SamiraWettasinghe/DAQ/README.md

# DAQ
Open source data acquisition system designed for the grassroots motorsports enthusiast.
