SamiraWettasinghe/DAQ/Schematic/Mega_Shield/Mega_Shieldv4.step

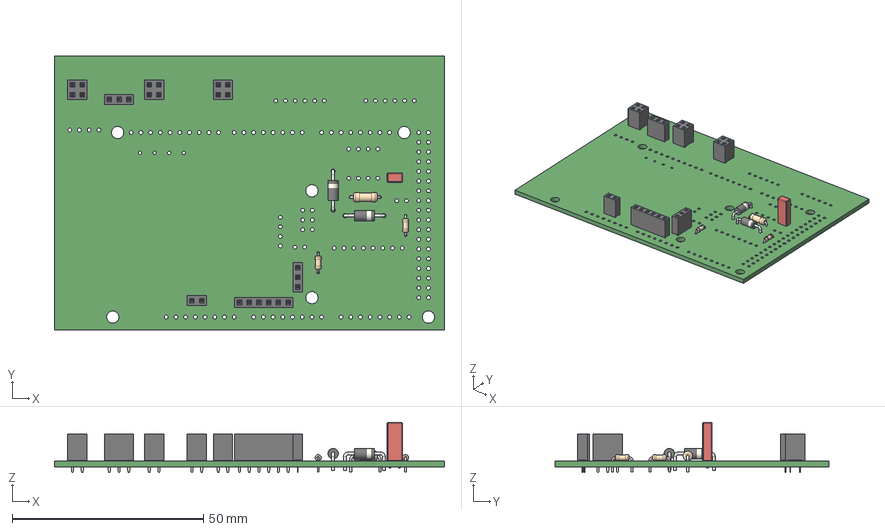
[picture p2: CAD file, 2021-03-08]
Schematic/Mega_Shield/Mega_Shieldv4.step
102.0 x 71.8 x 13.1 mm
