SamiraWettasinghe/DAQ/Schematic/TTS/DXF/TTS-B_Cu.dxf

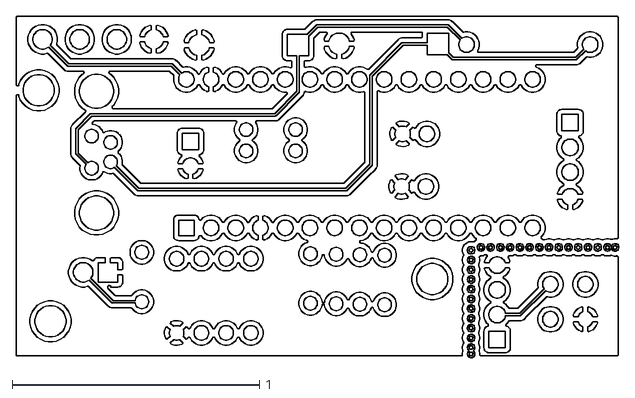
[picture p3: CAD file, 2021-02-11]
Schematic/TTS/DXF/TTS-B_Cu.dxf
2.44 x 1.38
