SamiraWettasinghe/DAQ/Schematic/TTS/TTSv4.step

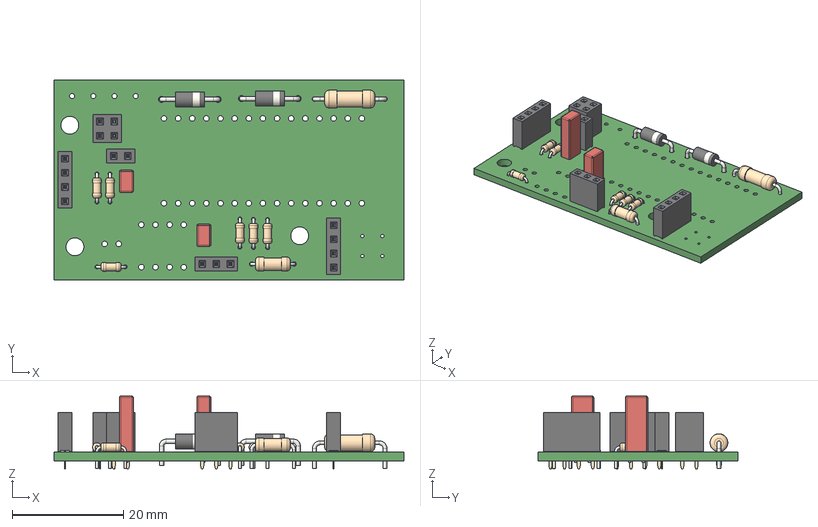
[picture p4: CAD file, 2021-03-08]
Schematic/TTS/TTSv4.step
62.9 x 35.9 x 13.1 mm
