SamiraWettasinghe/DAQ/Schematic/Mega_Shield/DXF/Mega_Shield-B_Cu.dxf

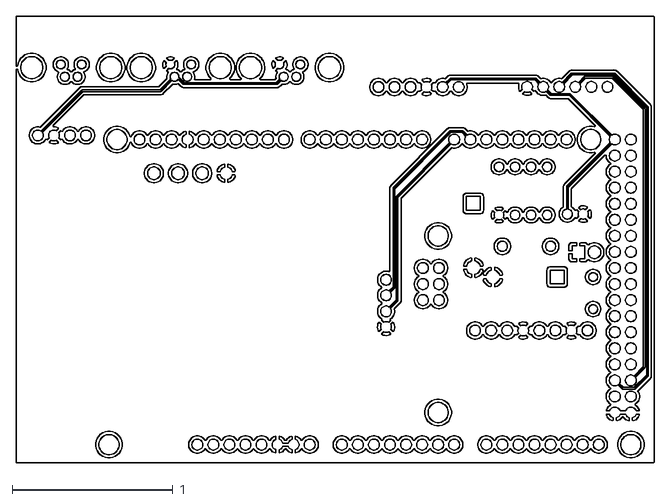
[picture p5: CAD file, 2021-02-11]
Schematic/Mega_Shield/DXF/Mega_Shield-B_Cu.dxf
3.97 x 2.78
