SamiraWettasinghe/DAQ/Schematic/Mega_Shield/Mega_Shieldv3.step

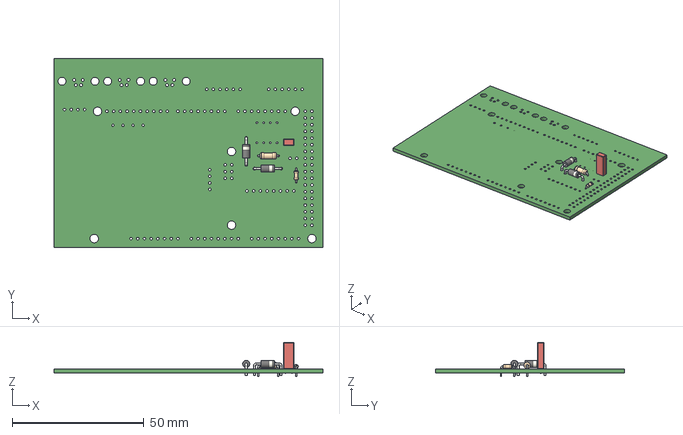
[picture p6: CAD file, 2021-02-11]
Schematic/Mega_Shield/Mega_Shieldv3.step
102.0 x 71.8 x 13.0 mm
