SamiraWettasinghe/DAQ/Schematic/TTS/DXF/TTS-Edge_Cuts.dxf

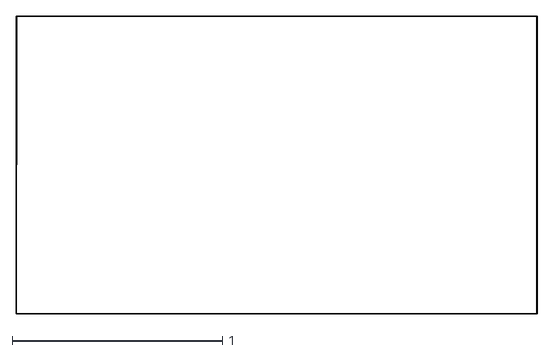
[picture p7: CAD file, 2021-02-11]
Schematic/TTS/DXF/TTS-Edge_Cuts.dxf
2.48 x 1.42
