SamiraWettasinghe/DAQ/Schematic/TTS/TTSv3.step

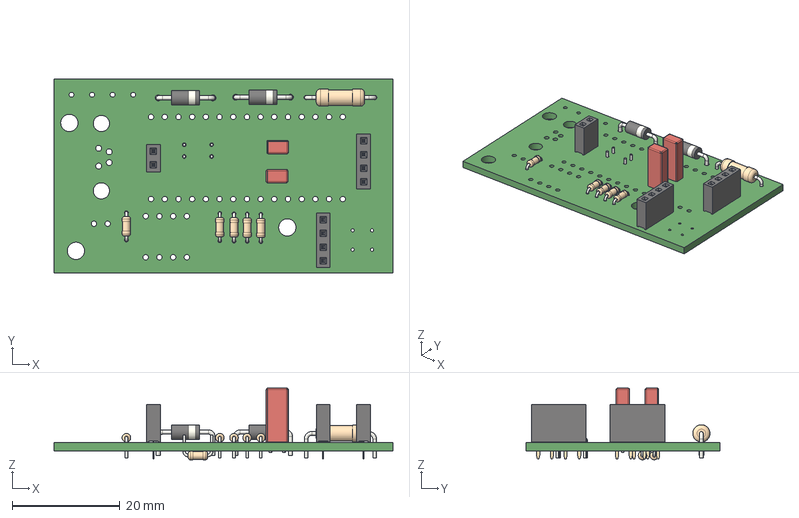
[picture p8: CAD file, 2021-02-11]
Schematic/TTS/TTSv3.step
62.9 x 35.9 x 13.3 mm
