SamiraWettasinghe/DAQ/Schematic/Mega_Shield/DXF/Mega_Shield-Edge_Cuts.dxf

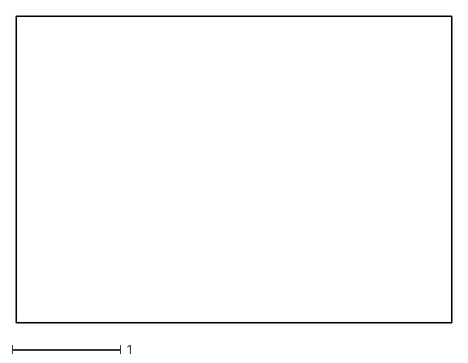
[picture p9: CAD file, 2021-02-11]
Schematic/Mega_Shield/DXF/Mega_Shield-Edge_Cuts.dxf
4.02 x 2.83
