SamiraWettasinghe/DAQ/Schematic/TTS/DXF/TTS-F_Cu.dxf

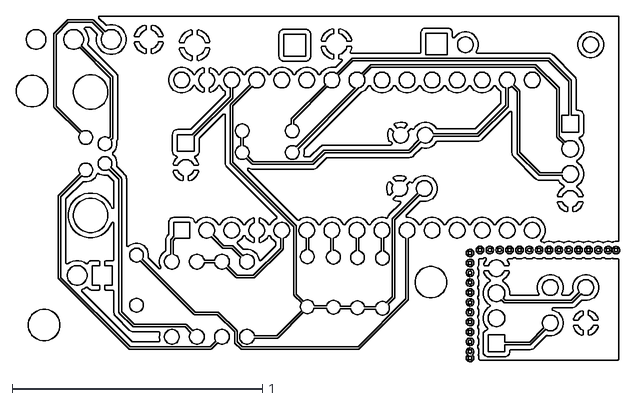
[picture p10: CAD file, 2021-02-11]
Schematic/TTS/DXF/TTS-F_Cu.dxf
2.41 x 1.38
