SamiraWettasinghe/DAQ/Schematic/TTS/TTS.step

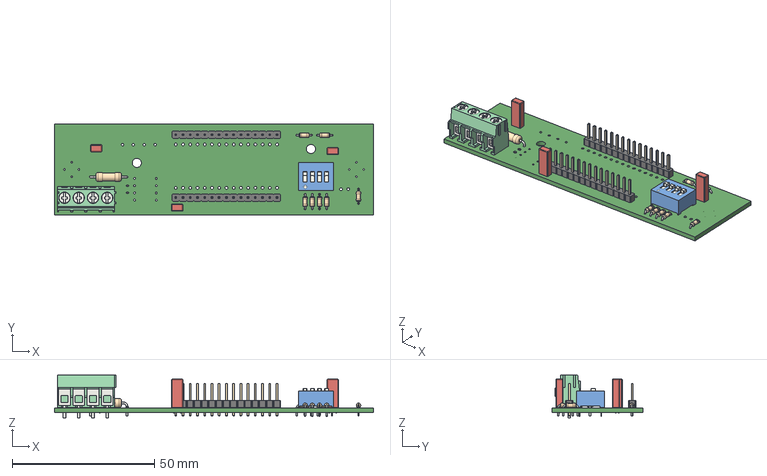
[picture p11: CAD file, 2020-11-12]
Schematic/TTS/TTS.step
112.0 x 32.0 x 15.0 mm
