SamiraWettasinghe/DAQ/(list of files, cad)

Other CAD files:
Schematic/Mega_Shield/DXF/Mega_Shield-B_Mask.dxf
Schematic/Mega_Shield/DXF/Mega_Shield-B_SilkS.dxf
Schematic/Mega_Shield/DXF/Mega_Shield-F_Mask.dxf
Schematic/Mega_Shield/DXF/Mega_Shield-F_SilkS.dxf
Schematic/TTS/DXF/TTS-B_Mask.dxf
Schematic/TTS/DXF/TTS-B_Paste.dxf
Schematic/TTS/DXF/TTS-B_SilkS.dxf
Schematic/TTS/DXF/TTS-F_Mask.dxf
Schematic/TTS/DXF/TTS-F_Paste.dxf
Schematic/TTS/DXF/TTS-F_SilkS.dxf
