SamiraWettasinghe/DAQ/Schematic/TTS/PDFs/TTS-B_Cu.pdf

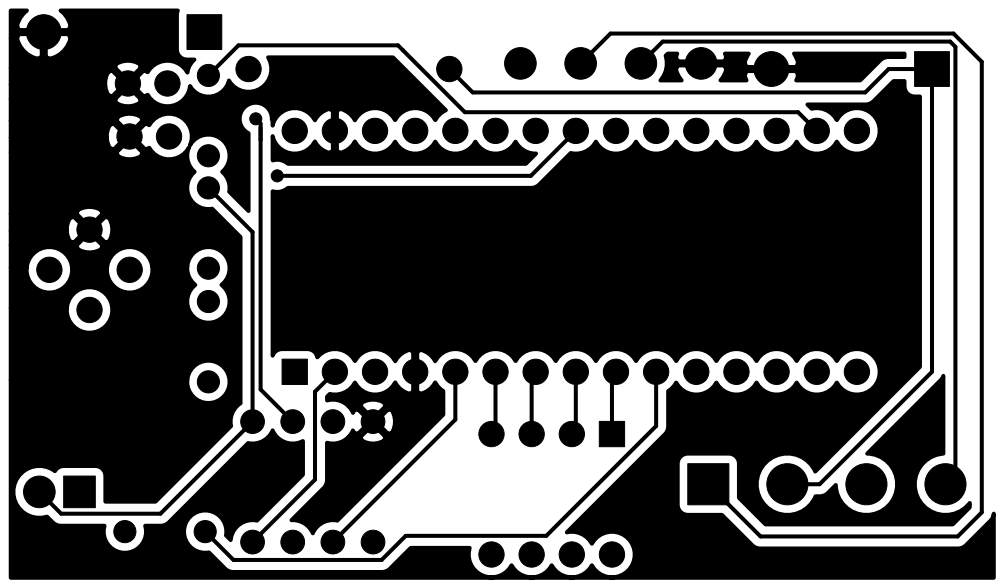
[picture p12: page 1]
