SamiraWettasinghe/DAQ/Schematic/TTS/PDFs/TTS-B_Mask.pdf

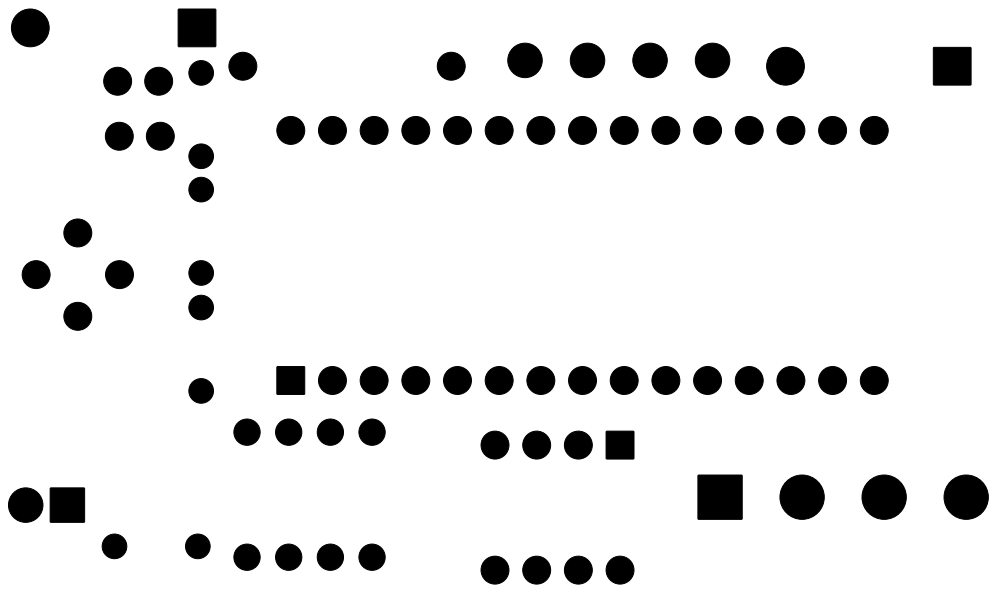
[picture p13: page 1]
