SamiraWettasinghe/DAQ/Schematic/TTS/PDFs/TTS-F_Cu.pdf

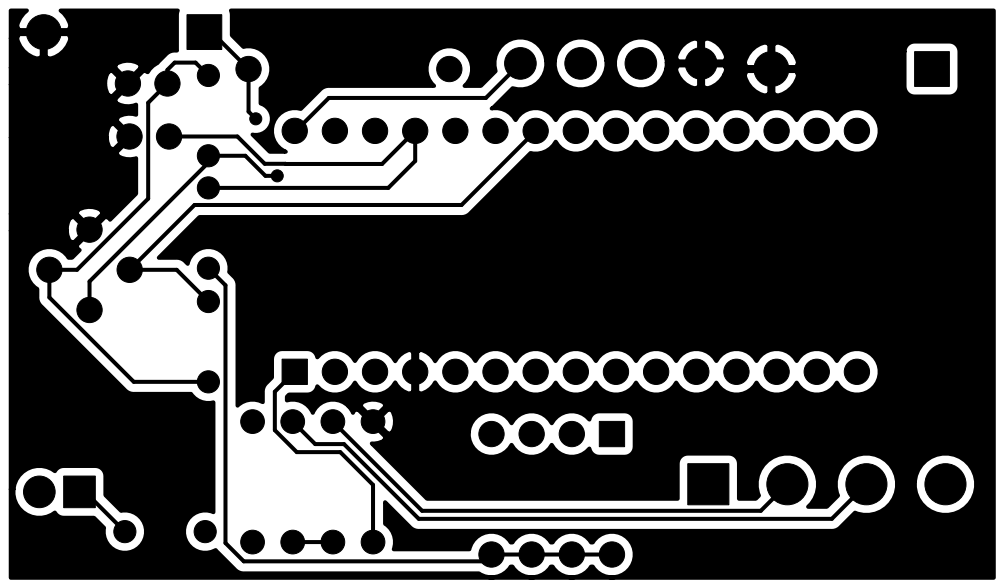
[picture p14: page 1]
