SamiraWettasinghe/DAQ/Schematic/TTS/PDFs/TTS-F_SilkS.pdf

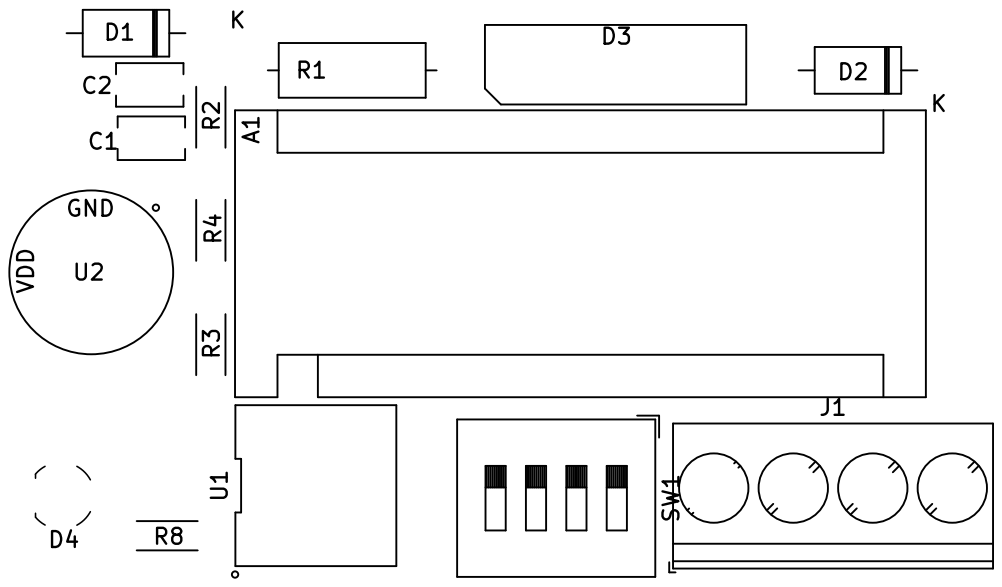
[picture p15: page 1]
