SamiraWettasinghe/DAQ/Schematic/TTS/PDFs/TTS.pdf

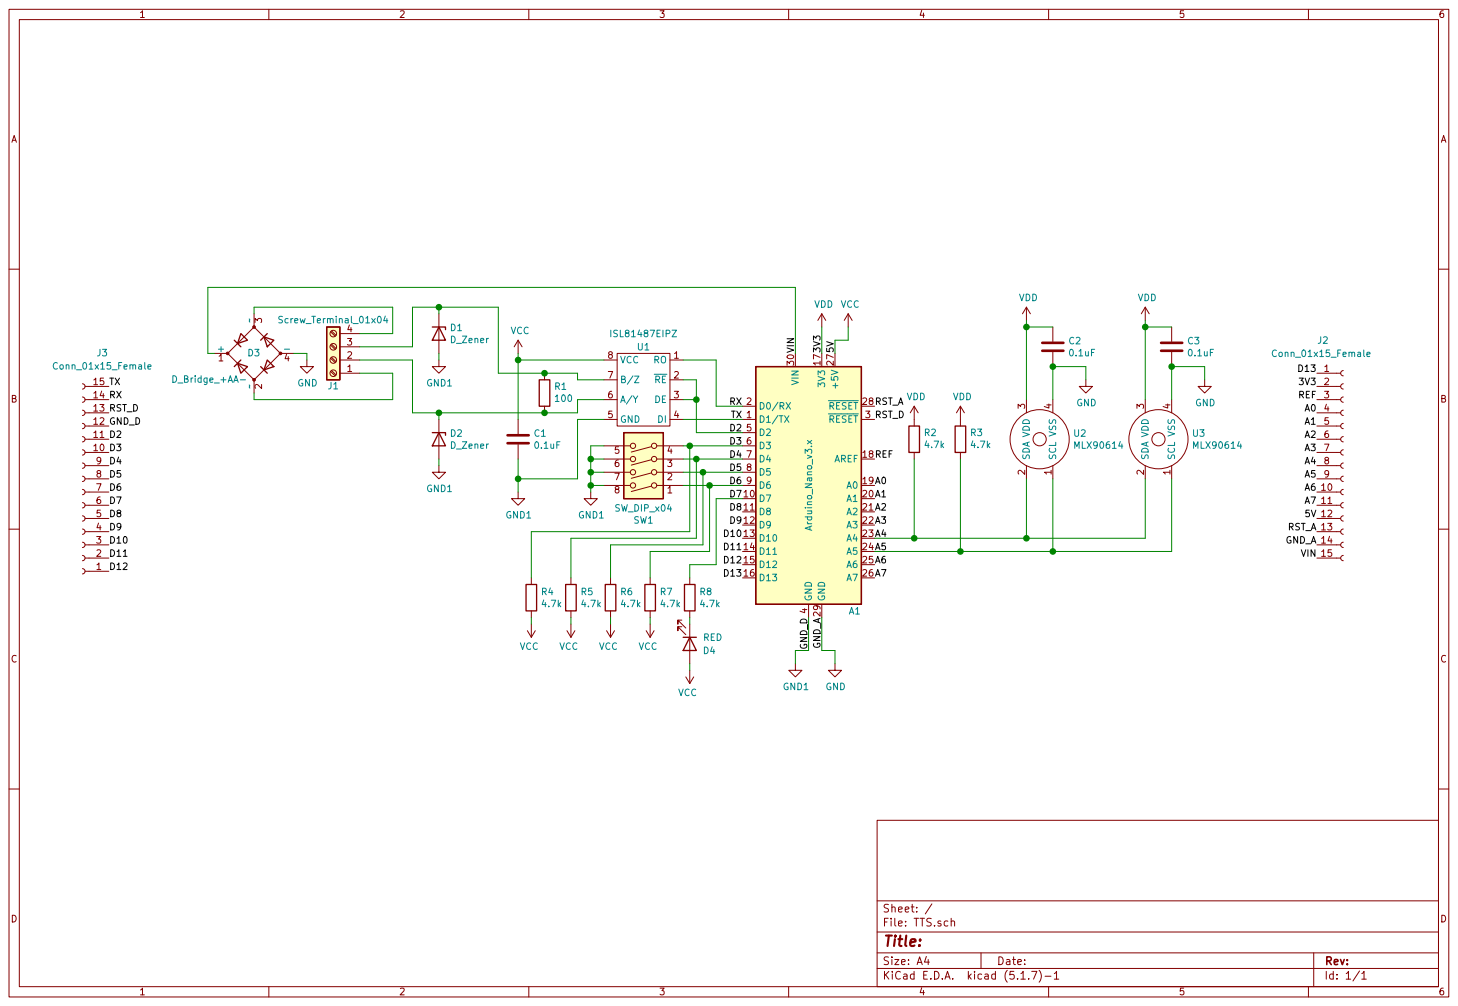
[picture p16: page 1]

Id: 1/1 Title: File: TTS.sch Sheet: /
