SamiraWettasinghe/DAQ/Schematic/Mega_Shield/Mega_Shield.kicad_pcb

## KiCad design Schematic/Mega_Shield/Mega_Shield.kicad_pcb (2021-03-08)

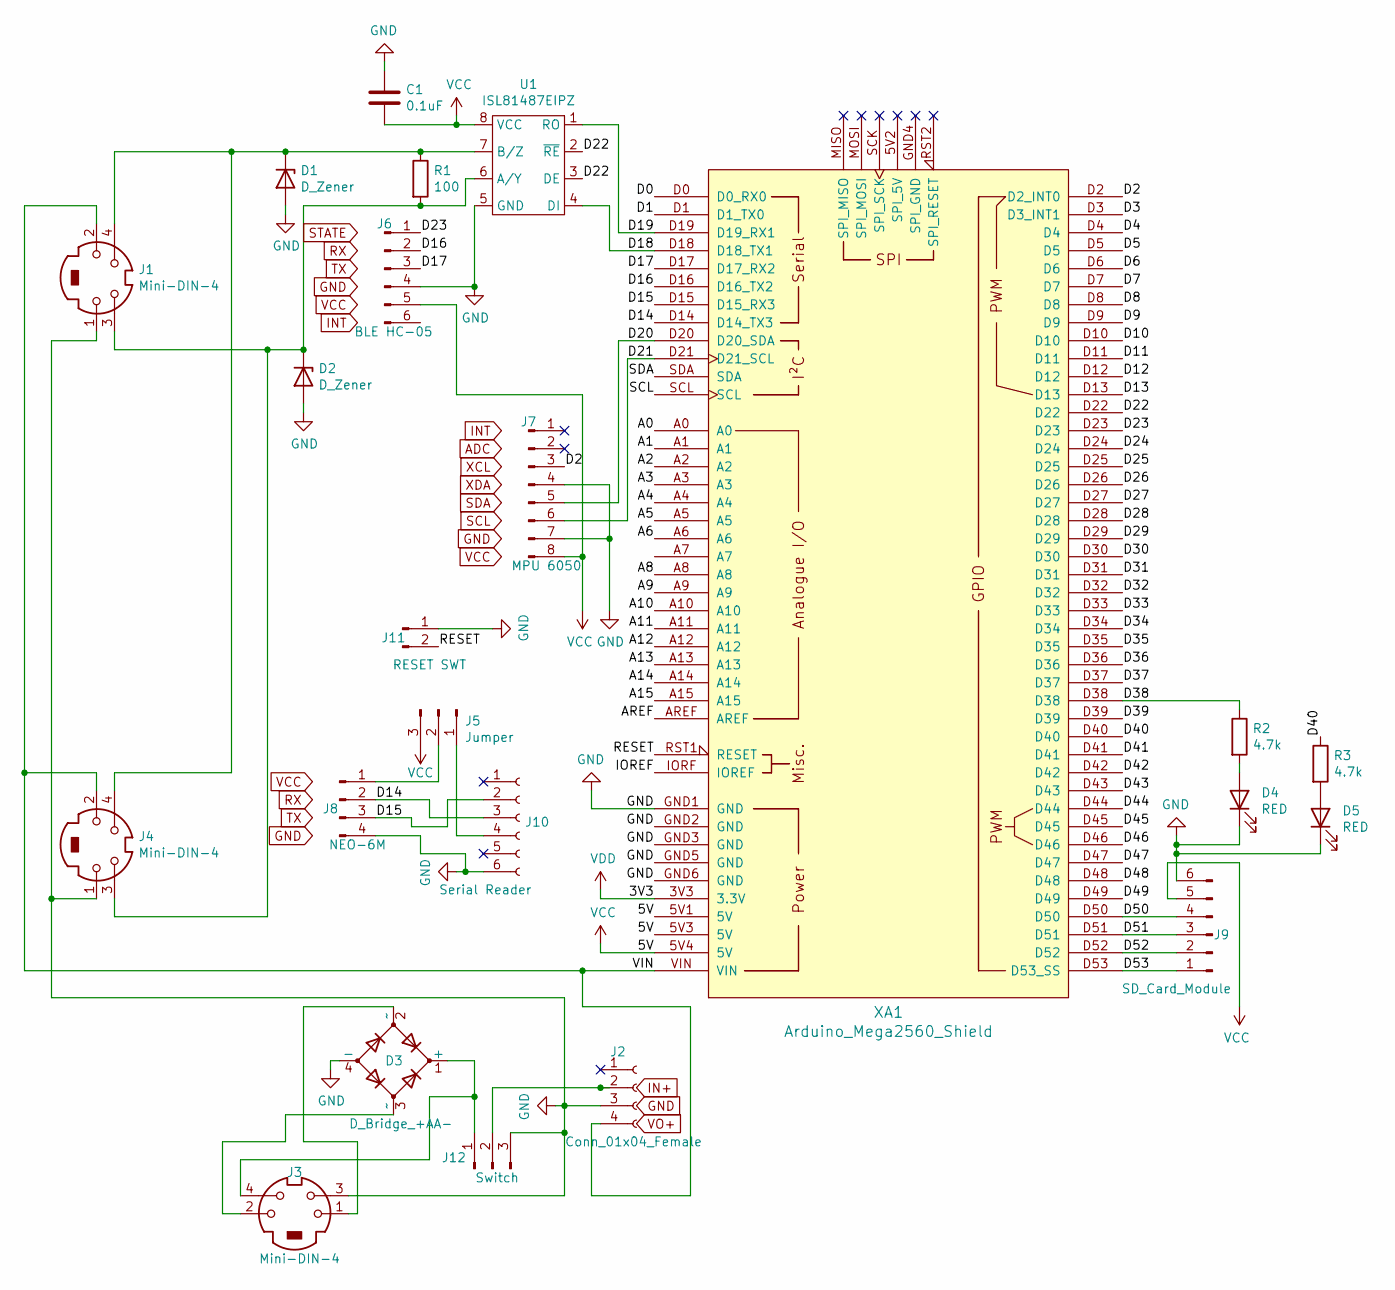
[picture p17: schematic Mega_Shield.sch]

Parts:
C1: 0.1uF; C_Rect_L4.0mm_W2.5mm_P2.50mm
D1, D2: D_Zener; D_DO-41_SOD81_P10.16mm_Horizontal
D3: D_Bridge_+AA-; KBP306GTB
D4, D5: RED; LED_3mm_Radial
J1, J3, J4: Mini-DIN-4; PinSocket_2x02_P2.54mm_Vertical
J2: Conn_01x04_Female; Voltage_Regulator
J5: Jumper; PinSocket_1x03_P2.54mm_Vertical
J6: BLE HC-05; BLEHC-05
J7: MPU 6050; GY-521
J8: NEO-6M
J9: SD_Card_Module; SD_Module_Vertical
J10: Serial Reader; PinSocket_1x06_P2.54mm_Vertical
J11: RESET SWT; PinSocket_1x02_P2.54mm_Vertical
J12: Switch; PinSocket_1x03_P2.54mm_Vertical
R1: 100; R_Axial_DIN0207_L6.3mm_D2.5mm_P7.62mm_Horizontal
R2, R3: 4.7k; R_Axial_DIN0204_L3.6mm_D1.6mm_P5.08mm_Horizontal
U1: ISL81487EIPZ; ISL81487EIPZ-PDIP
XA1: Arduino_Mega2560_Shield

Connections:
/A0: XA1.A0
/A1: XA1.A1
/A2: XA1.A2
/A3: XA1.A3
/A4: XA1.A4
/A5: XA1.A5
/A6: XA1.A6
/A8: XA1.A8
/A9: XA1.A9
/A10: XA1.A10
/A11: XA1.A11
/A12: XA1.A12
/A13: XA1.A13
/A14: XA1.A14
/A15: XA1.A15
/AREF: XA1.AREF
/D0: XA1.D0 (D0_RX0)
/D1: XA1.D1 (D1_TX0)
/D2: J7.3, XA1.D2 (D2_INT0)
/D3: XA1.D3 (D3_INT1)
/D4: XA1.D4
/D5: XA1.D5
/D6: XA1.D6
/D7: XA1.D7
/D8: XA1.D8
/D9: XA1.D9
/D10: XA1.D10
/D11: XA1.D11
/D12: XA1.D12
/D13: XA1.D13
/D14: J8.2, J10.3, XA1.D14 (D14_TX3)
/D15: J8.3, J10.2, XA1.D15 (D15_RX3)
/D16: J6.2, XA1.D16 (D16_TX2)
/D17: J6.3, XA1.D17 (D17_RX2)
/D18: U1.4 (DI), XA1.D18 (D18_TX1)
/D19: U1.1 (RO), XA1.D19 (D19_RX1)
/D20: J7.5, XA1.D20 (D20_SDA)
/D21: J7.6, XA1.D21 (D21_SCL)
/D22: U1.2 (~RE), U1.3 (DE), XA1.D22
/D23: J6.1, XA1.D23
/D24: XA1.D24
/D25: XA1.D25
/D26: XA1.D26
/D27: XA1.D27
/D28: XA1.D28
/D29: XA1.D29
/D30: XA1.D30
/D31: XA1.D31
/D32: XA1.D32
/D33: XA1.D33
/D34: XA1.D34
/D35: XA1.D35
/D36: XA1.D36
/D37: XA1.D37
/D38: R2.1, XA1.D38
/D39: XA1.D39
/D40: R3.1, XA1.D40
/D41: XA1.D41
/D42: XA1.D42
/D43: XA1.D43
/D44: XA1.D44
/D45: XA1.D45
/D46: XA1.D46
/D47: XA1.D47
/D48: XA1.D48
/D49: XA1.D49
/D50: J9.4, XA1.D50
/D51: J9.3, XA1.D51
/D52: J9.2, XA1.D52
/D53: J9.1, XA1.D53 (D53_SS)
/IOREF: XA1.IORF (IOREF)
/RESET: J11.2, XA1.RST1 (RESET)
/VIN: J1.2, J2.4, J4.2, XA1.VIN
GND: C1.1, D1.2 (A), D2.2 (A), D3.4 (-), D4.1 (K), D5.1 (K), J1.1, J2.3, J3.3, J4.1, J6.4, J7.4, J7.7, J8.4, J9.6, J10.6, J11.1, J12.3, U1.5 (GND), XA1.GND1 (GND), XA1.GND2 (GND), XA1.GND3 (GND), XA1.GND5 (GND), XA1.GND6 (GND)
unnamed: D1.1 (K), J1.4, J4.4, R1.1, U1.7 (B/Z)
unnamed: D2.1 (K), J1.3, J4.3, R1.2, U1.6 (A/Y)
unnamed: D3.1 (+), J3.4, J12.1
unnamed: D3.2 (~~), J3.1
unnamed: D3.3 (~~), J3.2
unnamed: D4.2 (A), R2.2
unnamed: D5.2 (A), R3.2
unnamed: J5.2, J8.1
unnamed: J5.1, J10.4
unnamed: J2.2, J12.2
SCL: XA1.SCL
SDA: XA1.SDA
VCC: C1.2, J5.3, J6.5, J7.8, J9.5, U1.8 (VCC), XA1.5V1 (5V), XA1.5V3 (5V), XA1.5V4 (5V)
VDD: XA1.3V3 (3.3V)

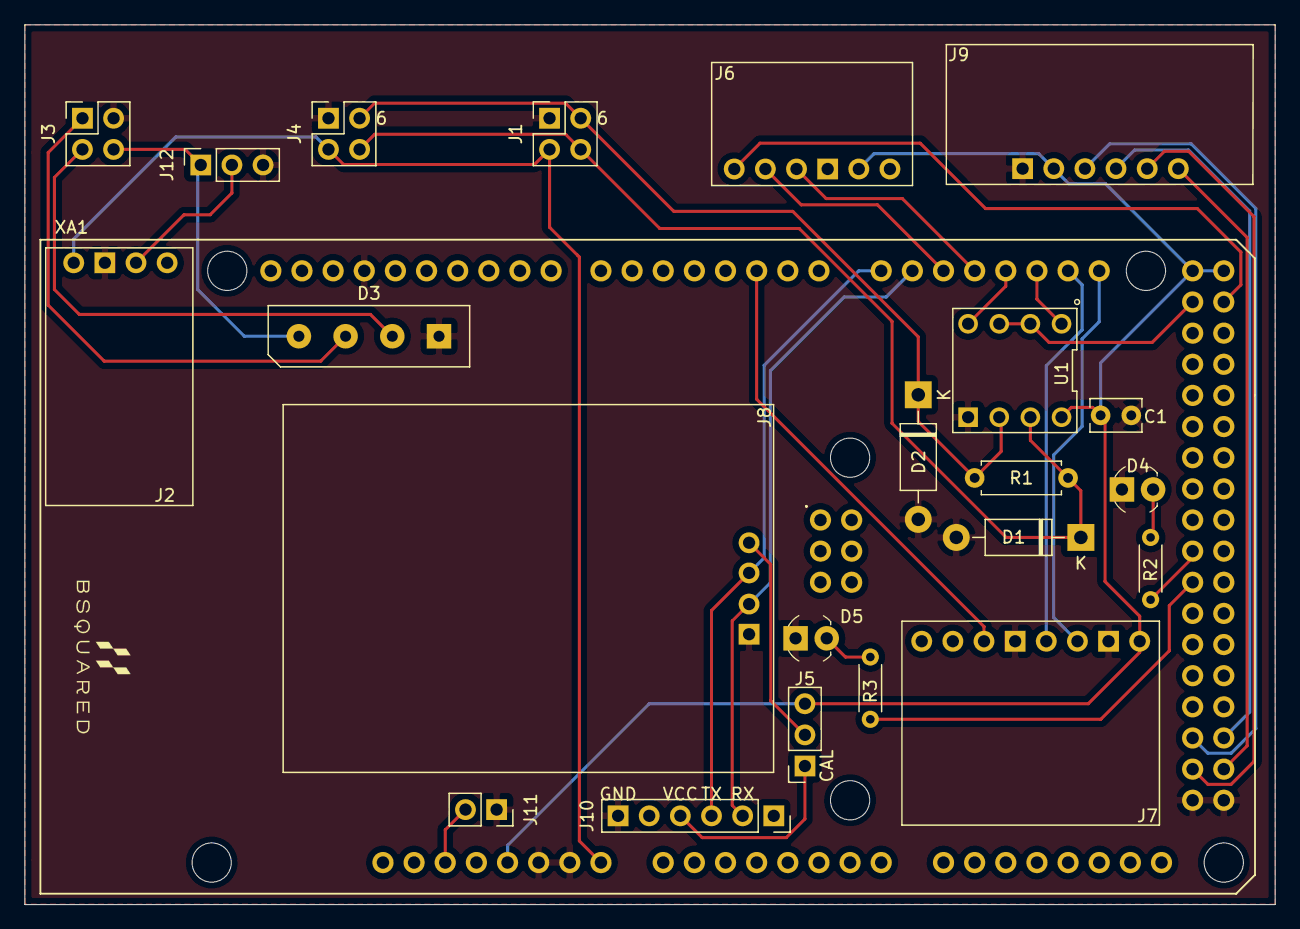
[picture p18: board Mega_Shield.kicad_pcb from above]

Board: 2 copper layers, 102.0 x 71.8 mm, 23 parts (0 on the bottom side), 31 nets.
