SamiraWettasinghe/DAQ/Schematic/TTS/TTS.kicad_pcb

## KiCad design Schematic/TTS/TTS.kicad_pcb (2021-03-08)

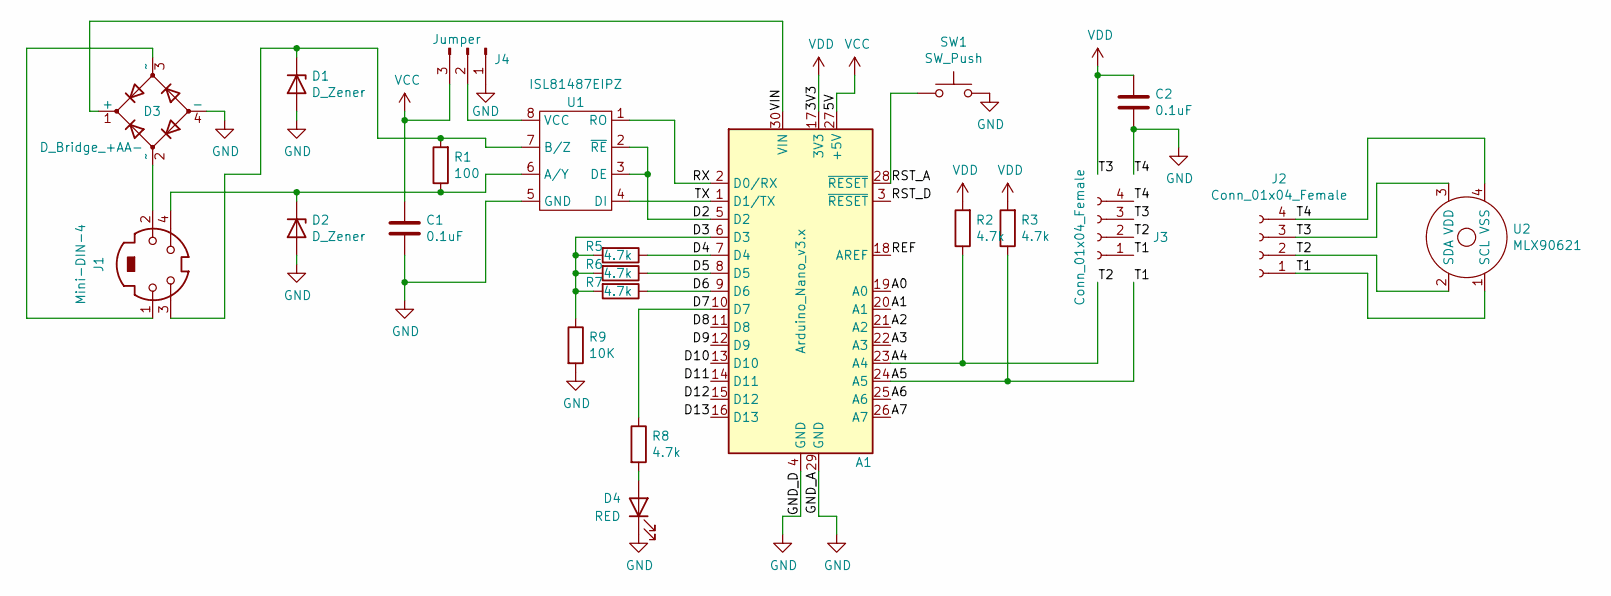
[picture p19: schematic TTS.sch]

Parts:
A1: Arduino_Nano_v3.x; Arduino_Nano
C1, C2: 0.1uF; C_Rect_L4.0mm_W2.5mm_P2.50mm
D1, D2: D_Zener; D_DO-41_SOD81_P10.16mm_Horizontal
D3: D_Bridge_+AA-; KBP306GTB
D4: RED; LED_3mm_Radial
J1: Mini-DIN-4; PinSocket_2x02_P2.54mm_Vertical
J2, J3: Conn_01x04_Female; PinSocket_1x04_P2.54mm_Vertical
J4: Jumper; PinSocket_1x03_P2.54mm_Vertical
R1: 100; R_Axial_DIN0309_L9.0mm_D3.2mm_P12.70mm_Horizontal
R2, R3, R5, R6, R7, R8: 4.7k; R_Axial_DIN0204_L3.6mm_D1.6mm_P5.08mm_Horizontal
R9: 10K; R_Axial_DIN0207_L6.3mm_D2.5mm_P7.62mm_Horizontal
SW1: SW_Push; PinSocket_1x02_P2.54mm_Vertical
U1: ISL81487EIPZ; ISL81487EIPZ-PDIP
U2: MLX90621; MLX90614ESF-BCC-000-TU

Connections:
/A0: A1.19 (A0)
/A1: A1.20 (A1)
/A2: A1.21 (A2)
/A3: A1.22 (A3)
/A4: A1.23 (A4), J2.2, J3.2, R2.1, U2.2 (SDA)
/A5: A1.24 (A5), J2.1, J3.1, R3.1, U2.1 (SCL)
/A6: A1.25 (A6)
/A7: A1.26 (A7)
/D2: A1.5 (D2), U1.2 (~RE), U1.3 (DE)
/D3: A1.6 (D3), R5.2, R6.2, R7.2, R9.1
/D4: A1.7 (D4), R5.1
/D5: A1.8 (D5), R6.1
/D6: A1.9 (D6), R7.1
/D7: A1.10 (D7), R8.1
/D8: A1.11 (D8)
/D9: A1.12 (D9)
/D10: A1.13 (D10)
/D11: A1.14 (D11)
/D12: A1.15 (D12)
/D13: A1.16 (D13)
/REF: A1.18 (AREF)
/RST_A: A1.28 (~RESET), SW1.1
/RST_D: A1.3 (~RESET)
/RX: A1.2 (D0/RX), U1.1 (RO)
/TX: A1.1 (D1/TX), U1.4 (DI)
/VIN: A1.30 (VIN), D3.1 (+)
GND: A1.4 (GND), A1.29 (GND), C1.2, C2.2, D1.2 (A), D2.2 (A), D3.4 (-), D4.1 (K), J2.4, J3.4, J4.1, R9.2, SW1.2, U1.5 (GND), U2.4 (VSS)
unnamed: D1.1 (K), J1.3, R1.2, U1.7 (B/Z)
unnamed: D2.1 (K), J1.4, R1.1, U1.6 (A/Y)
unnamed: D3.2 (~~), J1.2
unnamed: D3.3 (~~), J1.1
unnamed: D4.2 (A), R8.2
unnamed: J4.2, U1.8 (VCC)
VCC: A1.27 (+5V), C1.1, J4.3
VDD: A1.17 (3V3), C2.1, J2.3, J3.3, R2.2, R3.2, U2.3 (VDD)

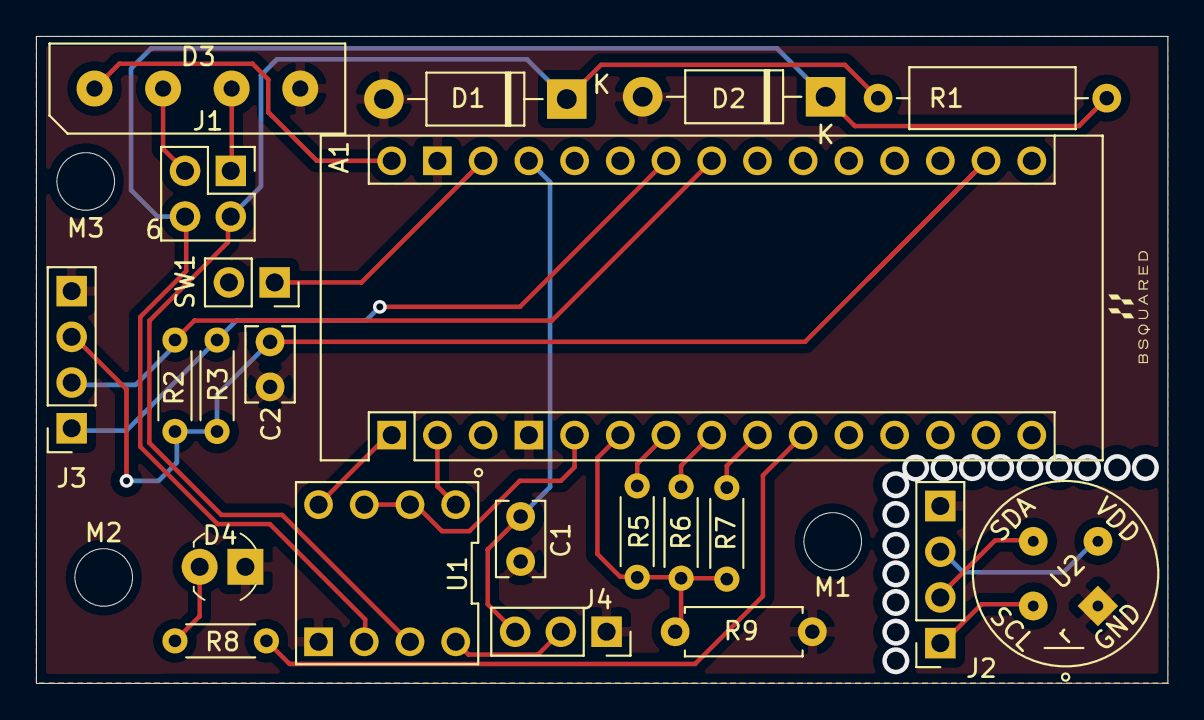
[picture p20: board TTS.kicad_pcb from above]

Board: 2 copper layers, 62.9 x 35.9 mm, 25 parts (0 on the bottom side), 21 nets.

Other parts of the board:
M1, M2, M3: MountingHole_3.2mm_M3
