SamiraWettasinghe/DAQ/Schematic/Test_board/SD card/SD Card/SD Card.kicad_pcb

## KiCad design Schematic/Test_board/SD card/SD Card/SD Card.kicad_pcb (2020-12-18)

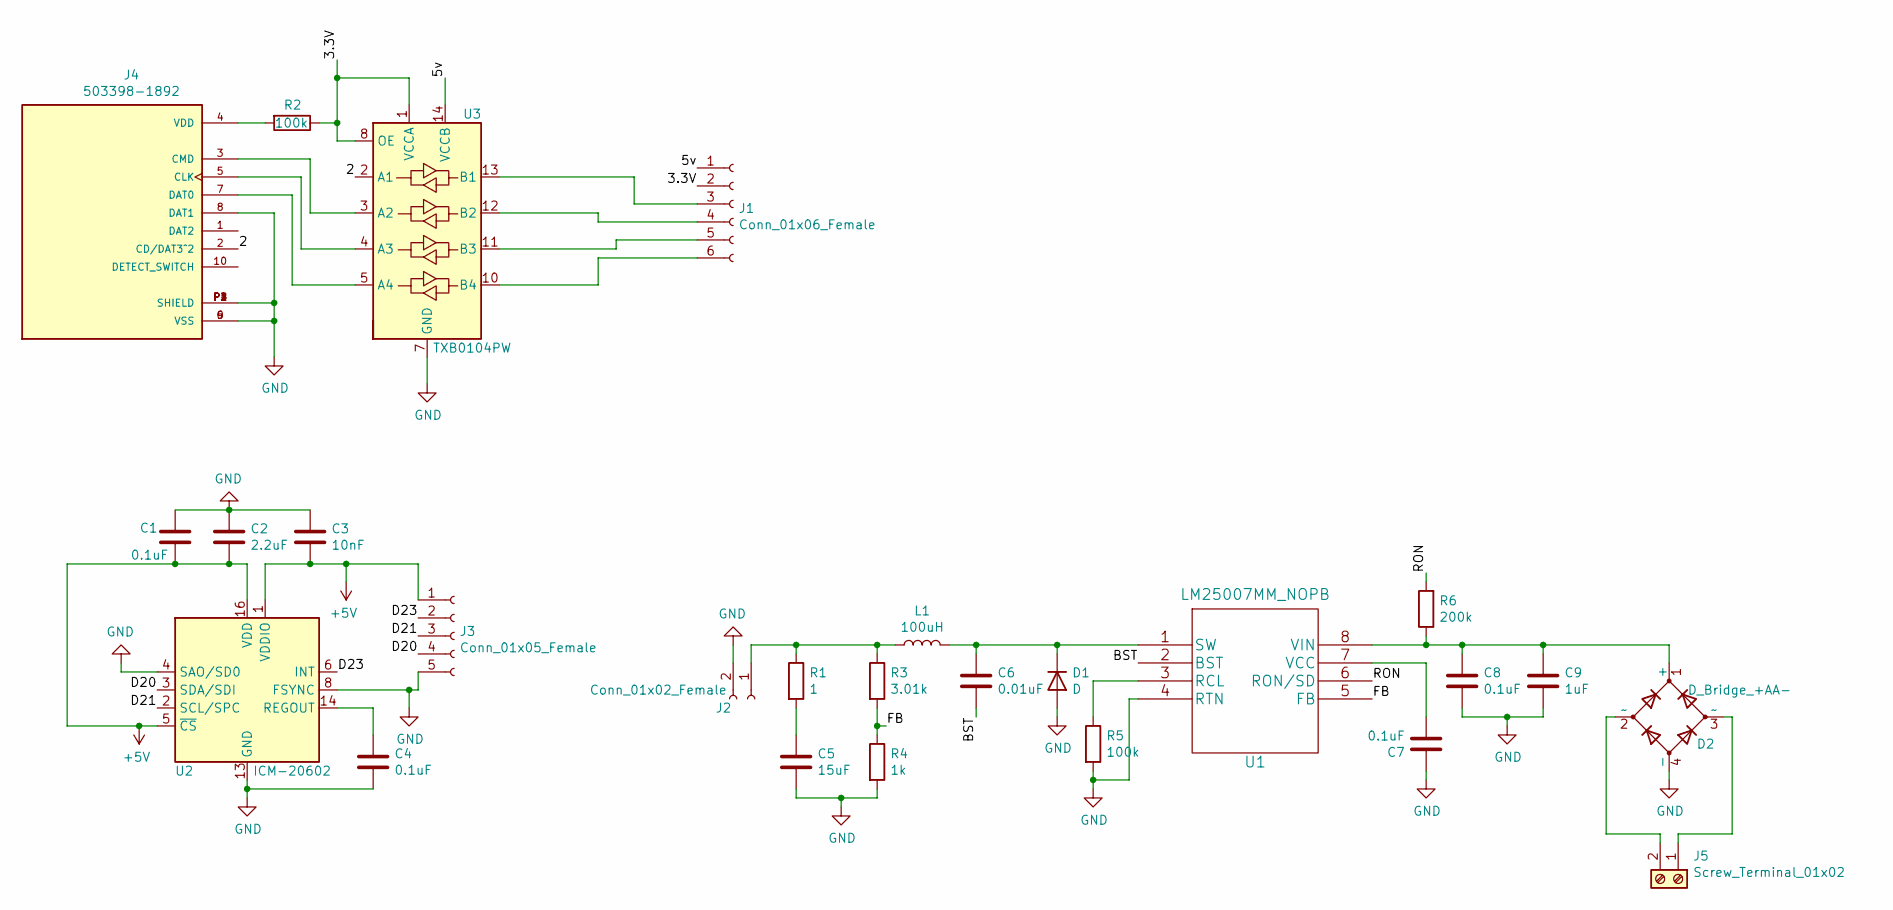
[picture p21: schematic SD Card.sch]

Parts:
C1, C4: 0.1uF; CP_Radial_D5.0mm_P2.50mm
C2: 2.2uF; CP_Radial_D5.0mm_P2.50mm
C3: 10nF; CP_Radial_D5.0mm_P2.50mm
C5: 15uF; C_1812_4532Metric_Pad1.57x3.40mm_HandSolder
C6: 0.01uF; C_1206_3216Metric_Pad1.33x1.80mm_HandSolder
C7, C8: 0.1uF; C_1206_3216Metric_Pad1.33x1.80mm_HandSolder
C9: 1uF; C_1812_4532Metric_Pad1.57x3.40mm_HandSolder
D1: D; D_SMA_Handsoldering
D2: D_Bridge_+AA-; KBP306GTB
J1: Conn_01x06_Female; PinHeader_1x06_P2.54mm_Vertical
J2: Conn_01x02_Female; PinHeader_1x02_P2.54mm_Vertical
J3: Conn_01x05_Female; PinHeader_1x05_P2.54mm_Vertical
J4: 503398-1892; MOLEX_503398-1892; PARTREV 0
J5: Screw_Terminal_01x02; TerminalBlock_Phoenix_PT-1,5-2-5.0-H_1x02_P5.00mm_Horizontal
L1: 100uH; L_TDK_SLF7045
R1: 1; R_1206_3216Metric_Pad1.30x1.75mm_HandSolder
R2: 100k; R_Axial_DIN0204_L3.6mm_D1.6mm_P5.08mm_Horizontal
R3: 3.01k; R_1206_3216Metric_Pad1.30x1.75mm_HandSolder
R4: 1k; R_1206_3216Metric_Pad1.30x1.75mm_HandSolder
R5: 100k; R_1206_3216Metric_Pad1.30x1.75mm_HandSolder
R6: 200k; R_1206_3216Metric_Pad1.30x1.75mm_HandSolder
U1: LM25007MM_NOPB; LM25007MM&slash_NOPB
U2: ICM-20602; LGA-16_3x3mm_P0.5mm_LayoutBorder3x5y
U3: TXB0104PW; TSSOP-14_4.4x5mm_P0.65mm

Connections:
+5V: C1.2, C2.2, C3.2, J3.1, U2.1 (VDDIO), U2.5 (~CS), U2.16 (VDD)
/2: J4.2 (CD/DAT3^2), U3.2 (A1)
/3.3V: J1.2, R2.1, U3.1 (VCCA), U3.8 (OE)
/5v: J1.1, U3.14 (VCCB)
/BST: C6.2, U1.2 (BST)
/D20: J3.4, U2.3 (SDA/SDI)
/D21: J3.3, U2.2 (SCL/SPC)
/D23: J3.2, U2.6 (INT)
/FB: R3.2, R4.1, U1.5 (FB)
/RON: R6.2, U1.6 (RON/SD)
GND: C1.1, C2.1, C3.1, C4.2, C5.2, C7.1, C8.2, C9.2, D1.2 (A), D2.4 (-), J2.2, J3.5, J4.6 (VSS), J4.8 (DAT1), J4.9 (VSS), J4.P1 (SHIELD), J4.P2 (SHIELD), J4.P3 (SHIELD), J4.P4 (SHIELD), R4.2, R5.2, U1.4 (RTN), U2.4 (SAO/SD0), U2.8 (FSYNC), U2.9 (GND), U2.10 (GND), U2.11 (GND), U2.12 (GND), U2.13 (GND), U2.15 (GND), U3.7 (GND)
unnamed: C4.1, U2.14 (REGOUT)
unnamed: C5.1, R1.2
unnamed: C6.1, D1.1 (K), L1.2, U1.1 (SW)
unnamed: C7.2, U1.7 (VCC)
unnamed: C8.1, C9.1, D2.1 (+), R6.1, U1.8 (VIN)
unnamed: D2.2 (~~), J5.2
unnamed: D2.3 (~~), J5.1
unnamed: J1.3, U3.13 (B1)
unnamed: J1.4, U3.12 (B2)
unnamed: J1.5, U3.11 (B3)
unnamed: J1.6, U3.10 (B4)
unnamed: J2.1, L1.1, R1.1, R3.1
unnamed: J4.3 (CMD), U3.3 (A2)
unnamed: J4.4 (VDD), R2.2
unnamed: J4.5 (CLK), U3.4 (A3)
unnamed: J4.7 (DAT0), U3.5 (A4)
unnamed: R5.1, U1.3 (RCL)

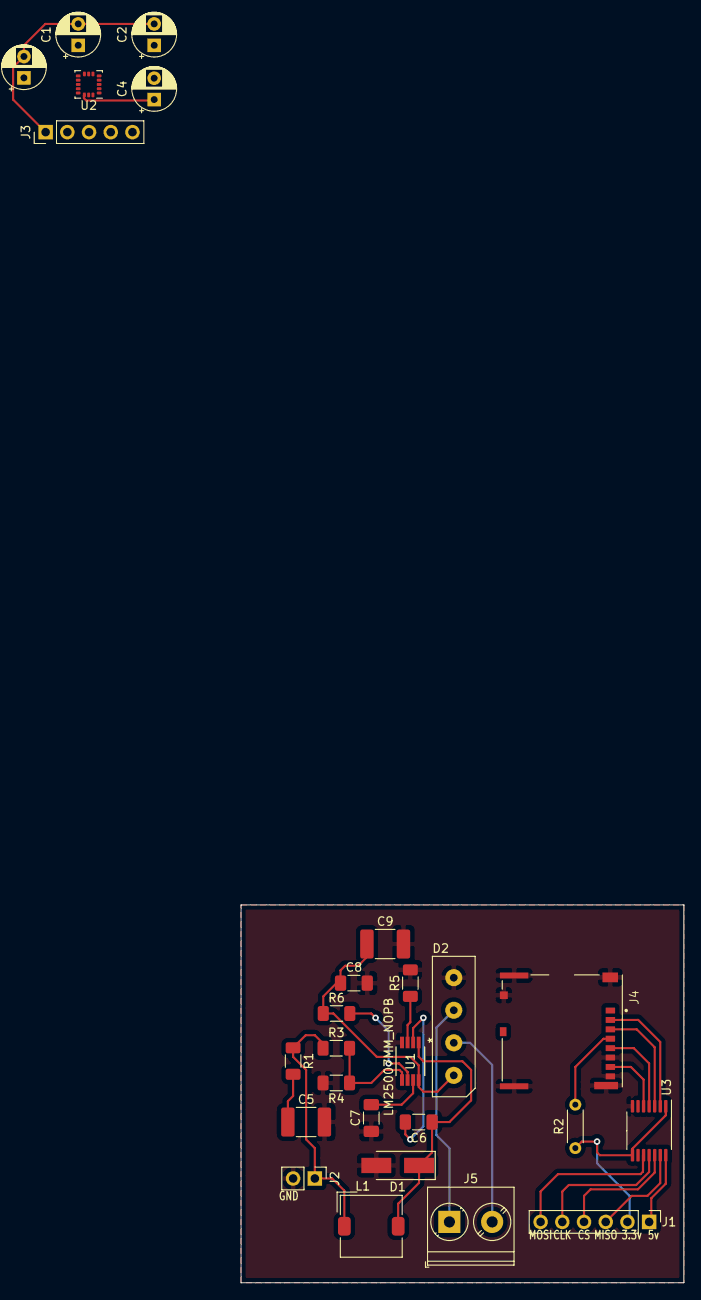
[picture p22: board SD Card.kicad_pcb from above]

Board: 2 copper layers, 51.8 x 44.2 mm, 26 parts (0 on the bottom side), 28 nets.
