SamiraWettasinghe/DAQ/MLX90621_in_mid_out_send4/MLX90621_in_mid_out_send4.ino

#include <MLX90621.h>
#include <Wire.h>

#define LED 7
#define LED_ON HIGH
#define LED_OFF LOW

#define IO 2
#define IO_TRANSMIT HIGH
#define IO_RECEIVE LOW

#define HEADER 0xFF
#define FL 0x95

const int Swt =  3;
const int P4 = 4;
const int P5 = 5;
const int P6 = 6;

int refresh_rate = 16;
MLX90621 sensor;

float temperatures[64];
double temp[3];
int tempAvg0;//Tin, Tmid, Tout
int tempAvg1;
int tempAvg2;
long time_taken;
long start_time;

boolean sendData = true;
byte messageRequest;
byte NANO = FL;//FL by default


void setup() {
  Wire.begin();
  sensor.initialise(refresh_rate);

  Serial.begin(115200);
  //LED
  pinMode(LED, OUTPUT);
  digitalWrite(LED, LED_ON);
 
  //Pwr for the address
  pinMode(Swt, OUTPUT);
  
  // DIP switch address
  pinMode(P4, INPUT);
  pinMode(P5, INPUT);
  pinMode(P6, INPUT);
digitalWrite(Swt, HIGH);
delay(100);
  //assign address
  if (digitalRead(P4) == HIGH) {
    NANO = 0x85;//FR
    Serial.print("FR");
    } else if (digitalRead(P5) == HIGH) {
    NANO = 0x75;//RR
    Serial.print("RR");
  } else if (digitalRead(P6) == HIGH) {
    NANO = 0x65;//RL
    Serial.print("RL");
  } else {
    NANO = 0x95;//FL
    Serial.print("FL");
  }
  digitalWrite(Swt, LOW);
  delay(100);
  digitalWrite(LED, LED_OFF);

  // I/O control for serial comms
  pinMode(2, OUTPUT);
  digitalWrite(LED, LED_ON);
  delay(500);
  digitalWrite(LED, LED_OFF);
}

void readSensor() {
  digitalWrite(LED, LED_ON);
  start_time = millis();
  sensor.get_temperatures(temperatures);
  temp[1] = 0;
  temp[2] = 0;
  temp[3] = 0;
  for (int x = 1; x < 16; x++) {
    temp[0] = 0;
    for (int y = 0; y < 4; y++) {
      temp[0] += temperatures[y * refresh_rate + x];
    }
    temp[0] = temp[0] / 4;
    if (x < 6) {
      //Tin
      temp[1] += temp[0];
    }
    else if (x > 10) {
      //Tout
      temp[3] += temp[0];
    }
    else {
      //Tmid
      temp[2] += temp[0];
    }
  }
  // save AvgTemp as integer
  tempAvg0 = temp[1] / 5;
  tempAvg1 = temp[2] / 5;
  tempAvg2 = temp[3] / 5;

  time_taken = millis() - start_time;
  //  delay(1);
}
void loop() {
  digitalWrite(IO, IO_RECEIVE);
  digitalWrite(LED, LED_ON);

  if (sendData) {
    while ((Serial.available() > 0) ) {
      messageRequest = Serial.read();
      if (messageRequest == FL) {
        digitalWrite(LED, LED_OFF);
        digitalWrite(IO, IO_TRANSMIT);
        digitalWrite(LED, LED_ON);
        sendData = false;
        readSensor();
      }
    }
  }

  if (!sendData) {
    digitalWrite(LED, LED_OFF);
    // HEADER is FF
    Serial.write(HEADER);
    delay(2);

    // FROM
    Serial.write(NANO);
    delay(2);

    // DATA payload
    Serial.write(highByte(tempAvg0));
    //delay(1);
    Serial.write(lowByte(tempAvg0));
    //delay(1);
    Serial.write(highByte(tempAvg1));
    //delay(1);
    Serial.write(lowByte(tempAvg1));
    //delay(1);
    Serial.write(highByte(tempAvg2));
    //delay(1);
    Serial.write(lowByte(tempAvg2));
    //delay(1);

    // end payload
    Serial.write(0x0f);
    //delay(2);
    digitalWrite(LED, LED_ON);
    sendData = true;
    Serial.flush();
    digitalWrite(IO, IO_RECEIVE);

  }
}
