SamiraWettasinghe/DAQ/Test Code/Test code TTS/MLX90621/MLX90621-Lite-master/examples/get_temperatures/get_temperatures.ino

#include "Arduino.h"
#include "i2c_t3.h"
#include "MLX90621.h"

int refresh_rate = 16;
MLX90621 sensor;

float temperatures[64];

void setup(){
    Serial.begin(115200);
    Serial.println("Starting MLX90621 thermopile sensor");
    pinMode(D1, OUTPUT);
    digitalWrite(D1, HIGH);

    Wire.begin(D2, D3);
    sensor.initialise(refresh_rate);
}

void loop(){
    Serial.println("\n\nReading sensor...");

    long start_time = millis();
    sensor.get_temperatures(temperatures);
    long time_taken = millis() - start_time;

    Serial.print("Time taken: ");
    Serial.println(time_taken);

    for(int y=0;y<64;y+=16){ //go through all the rows
        Serial.print('[');
        for(int x=0;x<16;x++){ //go through all the columns
            Serial.print(temperatures[y+x], 2);

            if (x < 15) {
                Serial.print(", ");
            }
        }
        
        Serial.println(']');
    }
    
    Serial.print("Ambient temperature: ");
    Serial.print(sensor.get_ambient_temperature());
    Serial.println("°C");
    delay(500);
}
