SamiraWettasinghe/DAQ/(commit log)

2020-08-13 Added OBDii data.
    Through OBD, added capability to read vehicle speed and RPM. Work still needs to be done to send CAN frames to Mega successfully. OBD is accessed through Sparkfun's UART.
    Vehicle CAN Project - Investigation
2020-08-18 Initial commit of accelerometer code.
    Added code to interface to MPU-6050. Code is from playgroud.arduino.cc/Main/MPU-6050. Raw values of accel, gyro, and temperature are recorded and sent through serial monitor.
    Accelerometer investigation
2020-08-20 Added dual accelerometer comms
    Set up ADO pin to ground for one sensor and 3.3V for the other sensor such that the sensors can have different addresses (0x68 and 0x69).
    Accelerometer and Gyrometer Investigation
2020-08-21 GPS and SD card data logger
    Ubloc Neo-6m GPS module is used - Pin 2 and 3 is as TX and RX reader
    Mirco SD card adapter module is connected with the following Pin IDs Vcc to 5v, MISO to pin 12 (50), MOSI to Pin 11 (51), SCK to pin 13 (52) and CS to Pin 4 (53). Note for Arduino UNO use Pin ID without brackets and for Mega use Pin ID with brackets.
2020-08-21 Organization and documentation and added CAN comms
    Created GPS folder to store the GPS code. Created integration documentation for accelerometer and the OBD-II data. Added CAN comms for the accelerometer data. 0x06 for linear acceleration and 0x07 for gyrometer.
    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
2020-09-15 Added SD Card integration.
    SD card is commmunicating via UART with Mega. Currently sending only accelerometer data.
    First evaluation day - Samira Wettasinghe
2020-09-17 Changed to SPI comms for SD card
    SPI comms working for SD card storage. No issues since CS is D11 while tire temps are on D12.
    SD Card Comms - Samira Wettasinghe
    [receive.ino]
2020-09-21 Added timestamp
    CAN transmits timestamp. SD card will store timestamp in hour minute millisecond format.
    Timestamp transmission - Samira Wettasinghe
2020-09-22 Tire temp timestamp coherency
    Added simple coherency check.
    Modified delays to be as short as possible to avoid filling the buffer.
    Created functions to clean up code.
    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
    [receive.ino, transmit.ino]
2020-09-26 Integrated GPS code. General cleanup.
    GPS code is integrated. Added hardware present calibrations. Cleaned up code to ensure that it works properly when all sensors are presnet. Removed some of the time stamp coherency checks for now, added as a backlog task.
    Installation Day 2 - Samira Wettasinghe
2020-09-29 Fixed OBD logging. Added system arch doc.
    OBD logging now done properly and logging quickly. Created initial revision of architecture document. Feature revisions made for Mega code as well.
    V2 Testing - Samira Wettasinghe
    [receive.ino]
2020-10-25 Added PCB designs
    Adding PCB design of Mega shield and tire temp sensors.
    Samira Wettasinghe
    [Mega_Shield.csv, Mega_Shield.kicad_pcb, Mega_Shield.sch, TTS.csv, TTS.kicad_pcb, TTS.sch]
2020-11-12 Updating schematic with Oshpark/Digikey order
    Updates to add various components and capability.
    2.2 Basic Sensor Suite
    [Mega_Shield.csv, Mega_Shield.kicad_pcb, Mega_Shield.sch, TTS.csv, TTS.kicad_pcb, TTS.sch, TTS.step]
2020-11-12 Differential wire concept
    Testing concept with serial comms.
    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
2020-11-17 DIP switch and status LED and IMU code integrated
    Added code to read from DIP switch and LED digital pins. IMU code added on mega shield. No data can be read on the i2c due to incorrect SCL/SDA pins being connected to IMU.
    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
2020-11-18 SD Card logging code added.
    SD card logic was added. CS may need modification based on new PCB design. This code will need to be tested.
    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
2020-11-20 Fixed schematic issues. Made code for TTS transmit
    Schematic issues documented on Trello card fixed. TTS differential wire transmit code for the TTS implemented. Still need to do auto adressing and time stamp transmission.
    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
    [Mega_Shield.kicad_pcb, Mega_Shield.sch]
2020-12-03 Verified UART comms.
    Made sure that UART was working with two sensors communicating with Mega.
    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
2020-12-10 Integration of IMU + comms algo upgrade.
    Upgraded comms method to use switch/case method. Integrade the IMU board onto the Mega shield.
    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
    [Mega_Shield.sch]
2020-12-15 Added diagnostic messages and error codes
    Added serial data print messages if data received doesn't make sense.
    Added error codes that will print to the data.
    Added LED for indicate an error has set.
    2.7 Diagnostic Software
    [nano_1.ino, receive.ino, transmit.ino]
2020-12-16 test board PCB design
    PCB include SD card and IMU
    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
    [SD Card.kicad_pcb, SD Card.sch]
2020-12-17 test board PCB design
    PCB includes SD card and IMU
    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
    [SD Card.kicad_pcb]
2020-12-17 Added power distribution to test board.
    Added the schematic and footprints needed for power distribution in test board.
    2.2. Basic Sensor Suite
    [SD Card.sch]
2020-12-18 Test board PCB design
    Board includes SD card, IMU and PDU
    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
    [SD Card.kicad_pcb, SD Card.sch]
2021-02-01 Implemented scheduler for consistent logging rates
    Scheduled the execution of the functions to ensure that data is stored at a reliable run rate.
    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
2021-02-11 Upadeted PCB design for Logger and for TTS
    Mega updated for BLE and reduced in size. Nano shield updated for
    MLX90621 array based sensor
    [Mega_Shield-B_Cu.dxf, Mega_Shield-B_Mask.dxf, Mega_Shield-B_SilkS.dxf, Mega_Shield-Edge_Cuts.dxf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]
2021-02-11 Test code added for New logger and TTS design
    Test code created to test bluetooth comunication to RaceChrono, MLX90621
    array based sensr and to test the PCB trace with individual modules,
    GPS, IMU and SD card.
2021-02-16 Udated logger and TTS for full sensor suit
    2.2 Basic Sensor Suit and 2.6 Array Based Tire Temps
    [Mega_Shield.kicad_pcb, Mega_Shield.sch]
2021-03-08 Verion 4 PCB and Code
    Updated PCB layout for version 4; for both TTS and Logger.
    Updated code to asign ID to TTS and to send data via BT
    [Mega_Shield-B_Cu.gbl, Mega_Shield-B_Mask.gbs, Mega_Shield-B_SilkS.gbo, Mega_Shield-Edge_Cuts.gm1, Mega_Shield-F_Cu.gtl, Mega_Shield-F_Mask.gts, Mega_Shield-F_SilkS.gto, Mega_Shield-NPTH.drl]
